kehribar/ice40helper/README.md

# ice40helper

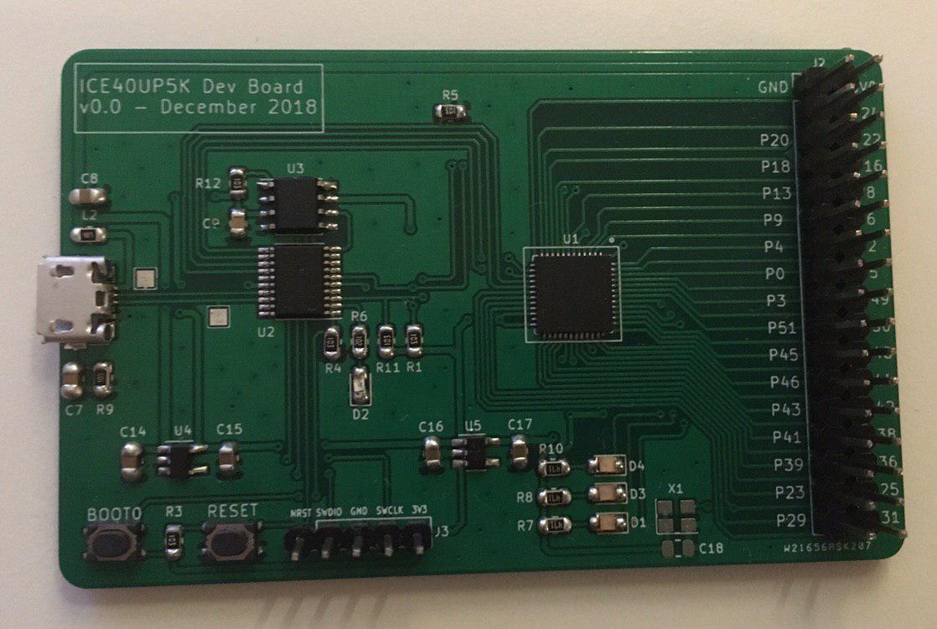
[picture p1: doc/proto_up5k.jpg]
