kehribar/ice40helper/hardware/up5k_v0/Readme.md

# UP5K Development Board

TODO: Add details ...
