kehribar/ice40helper/doc/proto_v0.jpg

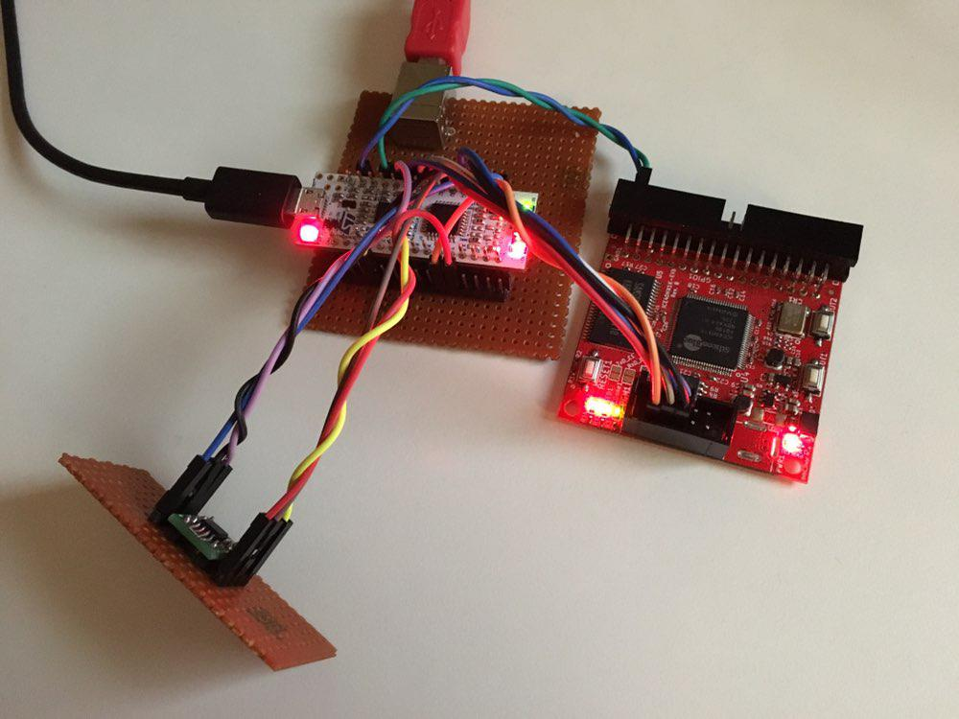
doc/proto_v0.jpg
