kehribar/ice40helper/hardware/up5k_v0/up5k_v0_brd.png

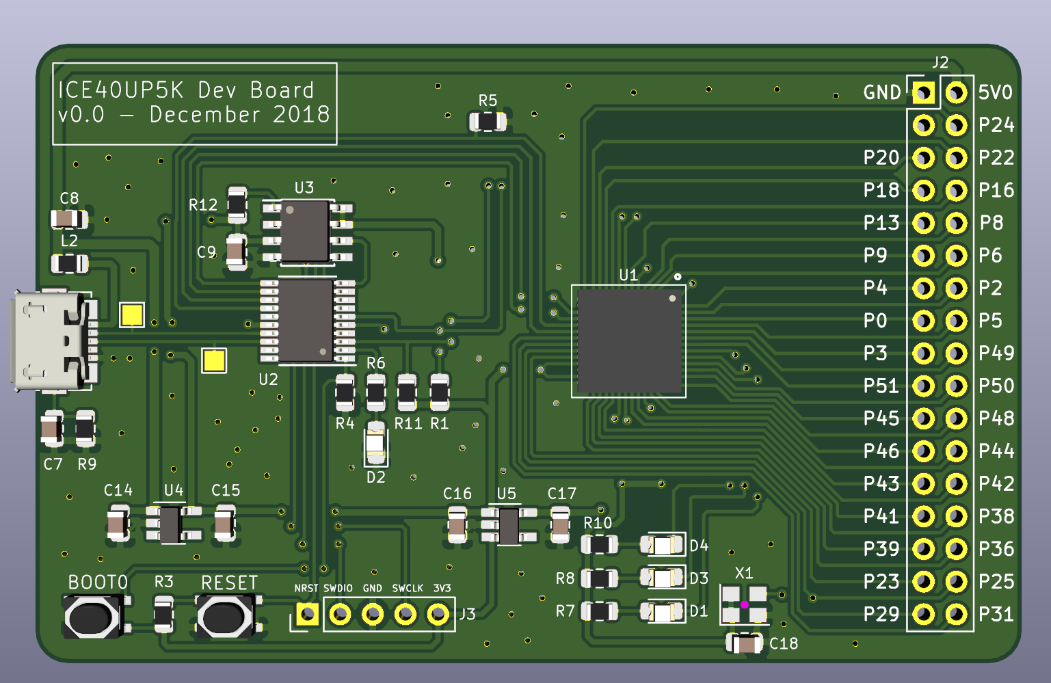
hardware/up5k_v0/up5k_v0_brd.png
