kehribar/ice40helper/hardware/up5k_v0/up5k_v0.pdf

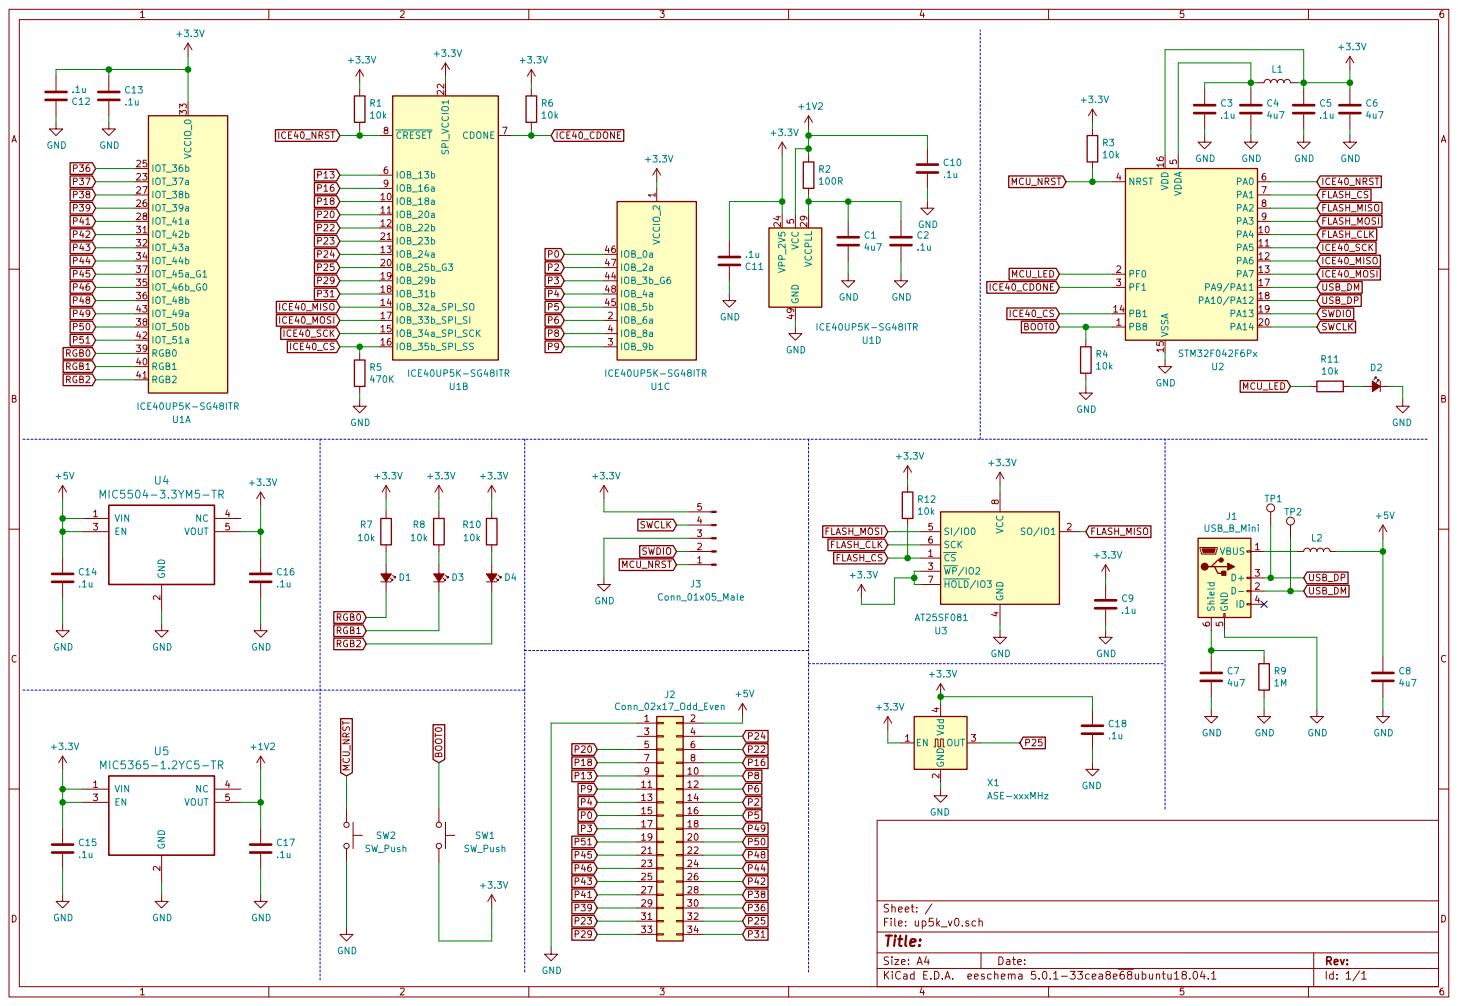
[picture p4: page 1]

2 VOUT 5 NC 4 VIN 1 EN 3 U4 MIC5504-3.3YM5-TR GND

4 SI/IO0 5 SCK 6 HOLD/IO3 7 VCC

2 VOUT 5 NC 4 VIN 1 EN 3 U5 MIC5365-1.2YC5-TR
