kehribar/ice40helper/hardware/up5k_v0/up5k_v0.kicad_pcb

## KiCad design hardware/up5k_v0/up5k_v0.kicad_pcb (2018-12-16)

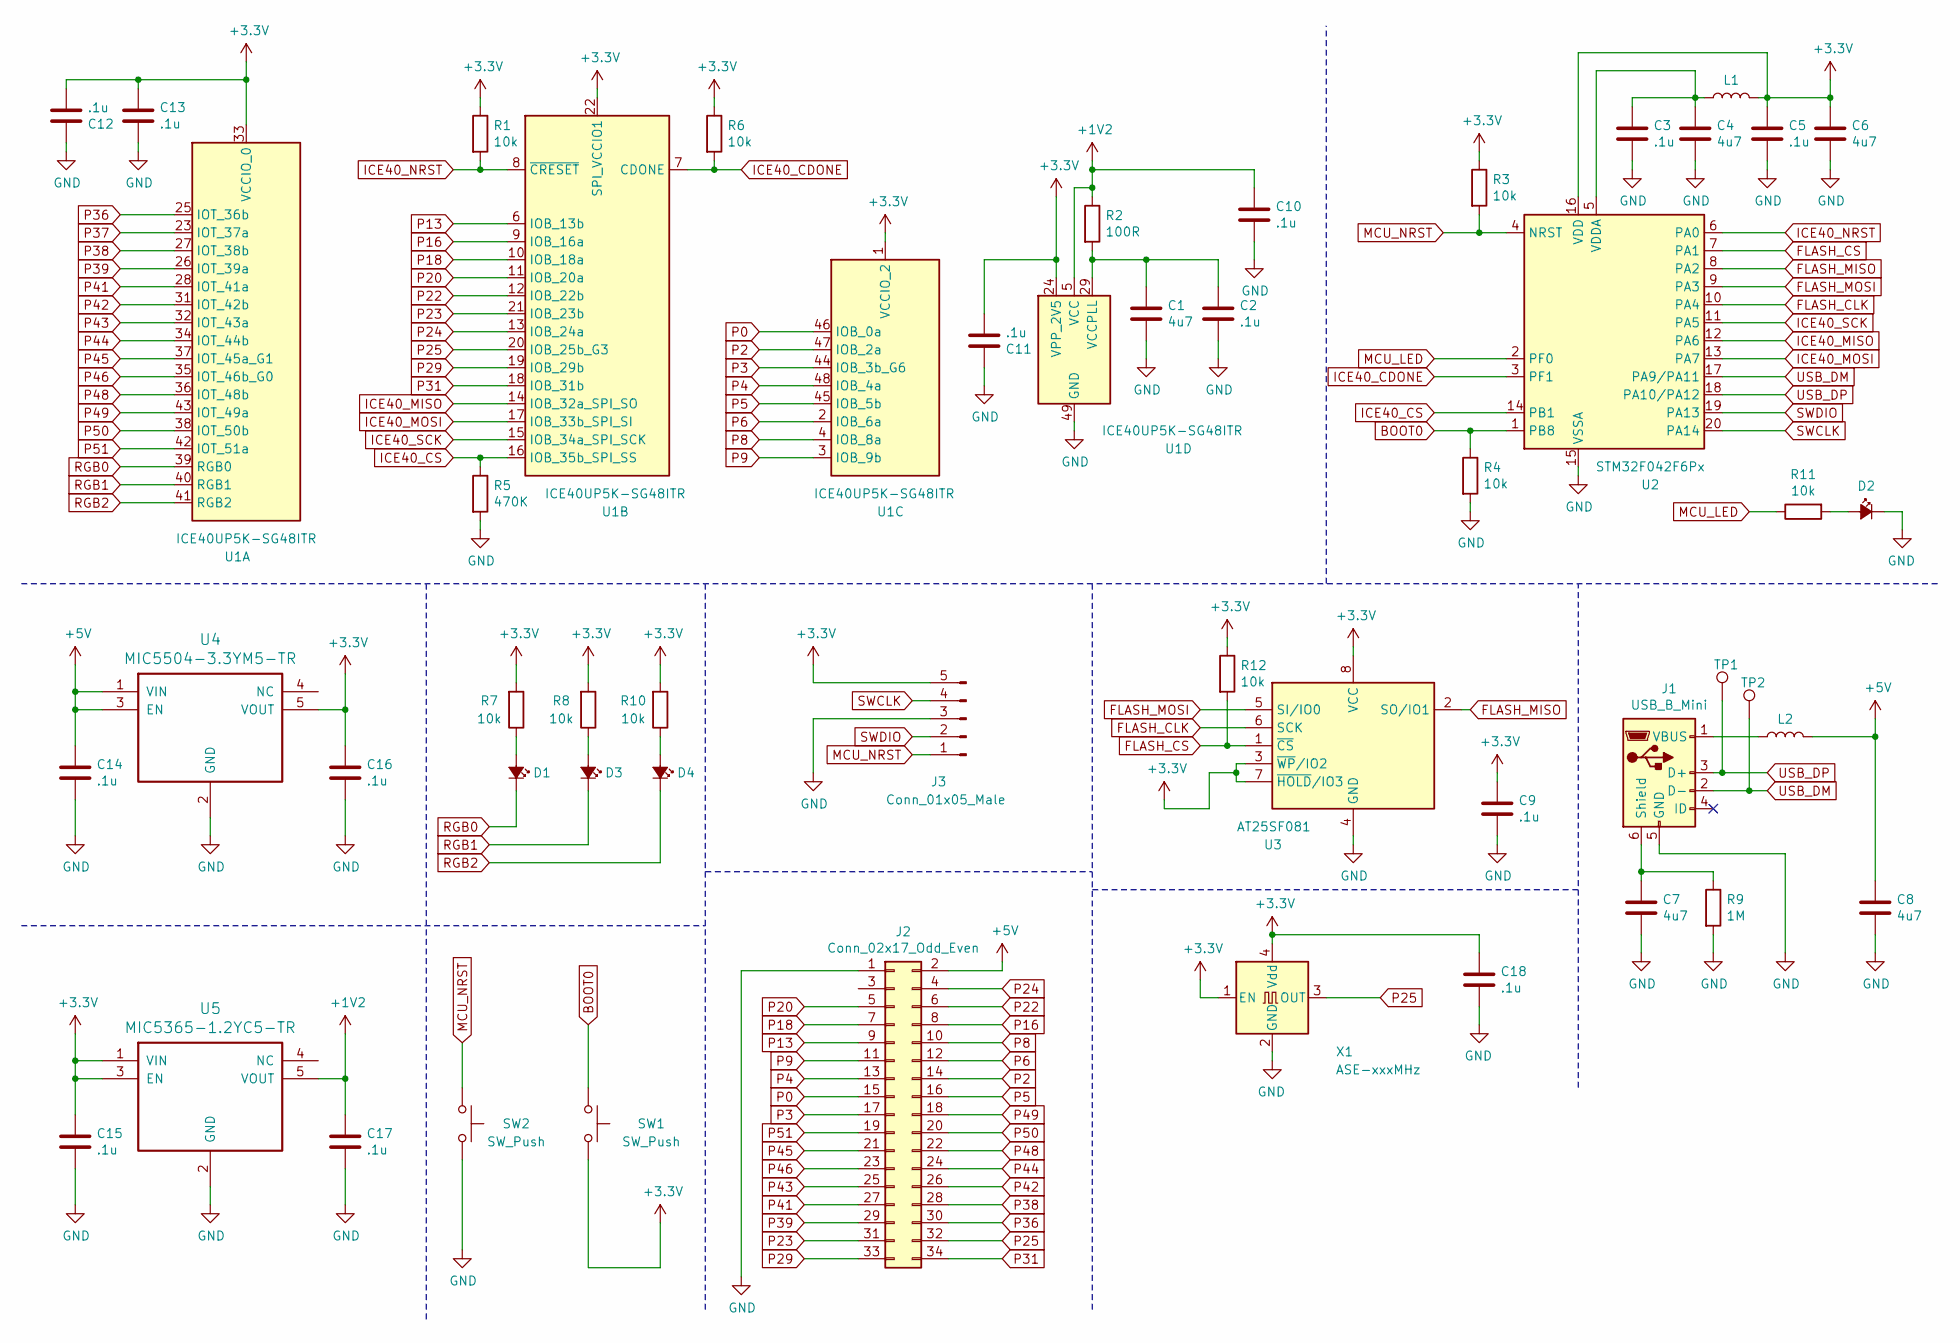
[picture p5: schematic up5k_v0.sch]

Parts:
C1, C4, C6, C7, C8: 4u7; C_0805_2012Metric
C2, C3, C5, C9, C10, C11, C12, C13, C14, C15, C16, C17, C18: .1u; C_0805_2012Metric
D1, D2, D3, D4: LED_Small_ALT; LED_0805_2012Metric_Castellated
J1: USB_B_Mini; USB_Micro-B_Molex_47346-0001
J2: Conn_02x17_Odd_Even; PinHeader_2x17_P2.54mm_Vertical
J3: Conn_01x05_Male; PinHeader_1x05_P2.54mm_Vertical
L1, L2: L; R_0805_2012Metric
R1, R3, R4, R6, R7, R8, R10, R11, R12: 10k; R_0805_2012Metric
R2: 100R; R_0805_2012Metric
R5: 470K; R_0805_2012Metric
R9: 1M; R_0805_2012Metric
SW1, SW2: SW_Push; PTS_810_SMT_Switch
TP1, TP2: TestPoint; TestPoint_Pad_1.5x1.5mm
U1: ICE40UP5K-SG48ITR; QFN-48-1EP_7x7mm_P0.5mm_EP5.6x5.6mm
U2: STM32F042F6Px; TSSOP-20_4.4x6.5mm_P0.65mm
U3: AT25SF081; SOIC-8_3.9x4.9mm_P1.27mm
U4: MIC5504-3.3YM5-TR; SOT-23-5_HandSoldering
U5: MIC5365-1.2YC5-TR; SOT-23-5_HandSoldering
X1: ASE-xxxMHz; Oscillator_SMD_Abracon_ASE-4Pin_3.2x2.5mm

Connections:
+1V2: C10.1, C17.1, R2.1, U1.5 (VCC), U1.30 (VCC), U5.5 (VOUT)
+3V3: C5.1, C6.1, C9.1, C11.2, C12.2, C13.1, C15.1, C16.1, C18.1, J3.5, L1.2, R1.1, R3.1, R6.1, R7.2, R8.2, R10.2, R12.1, SW1.2, U1.1 (VCCIO_2), U1.22 (SPI_VCCIO1), U1.24 (VPP_2V5), U1.33 (VCCIO_0), U2.16 (VDD), U3.3 (~WP~/IO2), U3.7 (~HOLD~/IO3), U3.8 (VCC), U4.5 (VOUT), U5.1 (VIN), U5.3 (EN), X1.1 (EN), X1.4 (Vdd)
+5V: C8.1, C14.1, J2.2, L2.2, U4.1 (VIN), U4.3 (EN)
BOOT0: R4.1, SW1.1, U2.1 (PB8)
FLASH_CLK: U2.10 (PA4), U3.6 (SCK)
FLASH_CS: R12.2, U2.7 (PA1), U3.1 (~CS)
FLASH_MISO: U2.8 (PA2), U3.2 (SO/IO1)
FLASH_MOSI: U2.9 (PA3), U3.5 (SI/IO0)
GND: C1.2, C2.2, C3.2, C4.2, C5.2, C6.2, C7.2, C8.2, C9.2, C10.2, C11.1, C12.1, C13.2, C14.2, C15.2, C16.2, C17.2, C18.2, D2.1 (K), J1.5 (GND), J2.1, J3.3, R4.2, R5.2, R9.2, SW2.2, U1.49 (GND), U2.15 (VSSA), U3.4 (GND), U4.2 (GND), U5.2 (GND), X1.2 (GND)
ICE40_CDONE: R6.2, U1.7 (CDONE), U2.3 (PF1)
ICE40_CS: R5.1, U1.16 (IOB_35b_SPI_SS), U2.14 (PB1)
ICE40_MISO: U1.14 (IOB_32a_SPI_SO), U2.12 (PA6)
ICE40_MOSI: U1.17 (IOB_33b_SPI_SI), U2.13 (PA7)
ICE40_NRST: R1.2, U1.8 (~CRESET), U2.6 (PA0)
ICE40_SCK: U1.15 (IOB_34a_SPI_SCK), U2.11 (PA5)
MCU_LED: R11.1, U2.2 (PF0)
MCU_NRST: J3.1, R3.2, SW2.1, U2.4 (NRST)
unnamed: C1.1, C2.1, R2.2, U1.29 (VCCPLL)
unnamed: C3.1, C4.1, L1.1, U2.5 (VDDA)
unnamed: C7.1, J1.6 (Shield), R9.1
unnamed: D1.2 (A), R7.1
unnamed: D2.2 (A), R11.2
unnamed: D3.2 (A), R8.1
unnamed: D4.2 (A), R10.1
unnamed: J1.1 (VBUS), L2.1
P0: J2.15, U1.46 (IOB_0a)
P2: J2.14, U1.47 (IOB_2a)
P3: J2.17, U1.44 (IOB_3b_G6)
P4: J2.13, U1.48 (IOB_4a)
P5: J2.16, U1.45 (IOB_5b)
P6: J2.12, U1.2 (IOB_6a)
P8: J2.10, U1.4 (IOB_8a)
P9: J2.11, U1.3 (IOB_9b)
P13: J2.9, U1.6 (IOB_13b)
P16: J2.8, U1.9 (IOB_16a)
P18: J2.7, U1.10 (IOB_18a)
P20: J2.5, U1.11 (IOB_20a)
P22: J2.6, U1.12 (IOB_22b)
P23: J2.31, U1.21 (IOB_23b)
P24: J2.4, U1.13 (IOB_24a)
P25: J2.32, U1.20 (IOB_25b_G3), X1.3 (OUT)
P29: J2.33, U1.19 (IOB_29b)
P31: J2.34, U1.18 (IOB_31b)
P36: J2.30, U1.25 (IOT_36b)
P37: U1.23 (IOT_37a)
P38: J2.28, U1.27 (IOT_38b)
P39: J2.29, U1.26 (IOT_39a)
P41: J2.27, U1.28 (IOT_41a)
P42: J2.26, U1.31 (IOT_42b)
P43: J2.25, U1.32 (IOT_43a)
P44: J2.24, U1.34 (IOT_44b)
P45: J2.21, U1.37 (IOT_45a_G1)
P46: J2.23, U1.35 (IOT_46b_G0)
P48: J2.22, U1.36 (IOT_48b)
P49: J2.18, U1.43 (IOT_49a)
P50: J2.20, U1.38 (IOT_50b)
P51: J2.19, U1.42 (IOT_51a)
RGB0: D1.1 (K), U1.39 (RGB0)
RGB1: D3.1 (K), U1.40 (RGB1)
RGB2: D4.1 (K), U1.41 (RGB2)
SWCLK: J3.4, U2.20 (PA14)
SWDIO: J3.2, U2.19 (PA13)
USB_DM: J1.2 (D-), TP2.1, U2.17 (PA9/PA11)
USB_DP: J1.3 (D+), TP1.1, U2.18 (PA10/PA12)

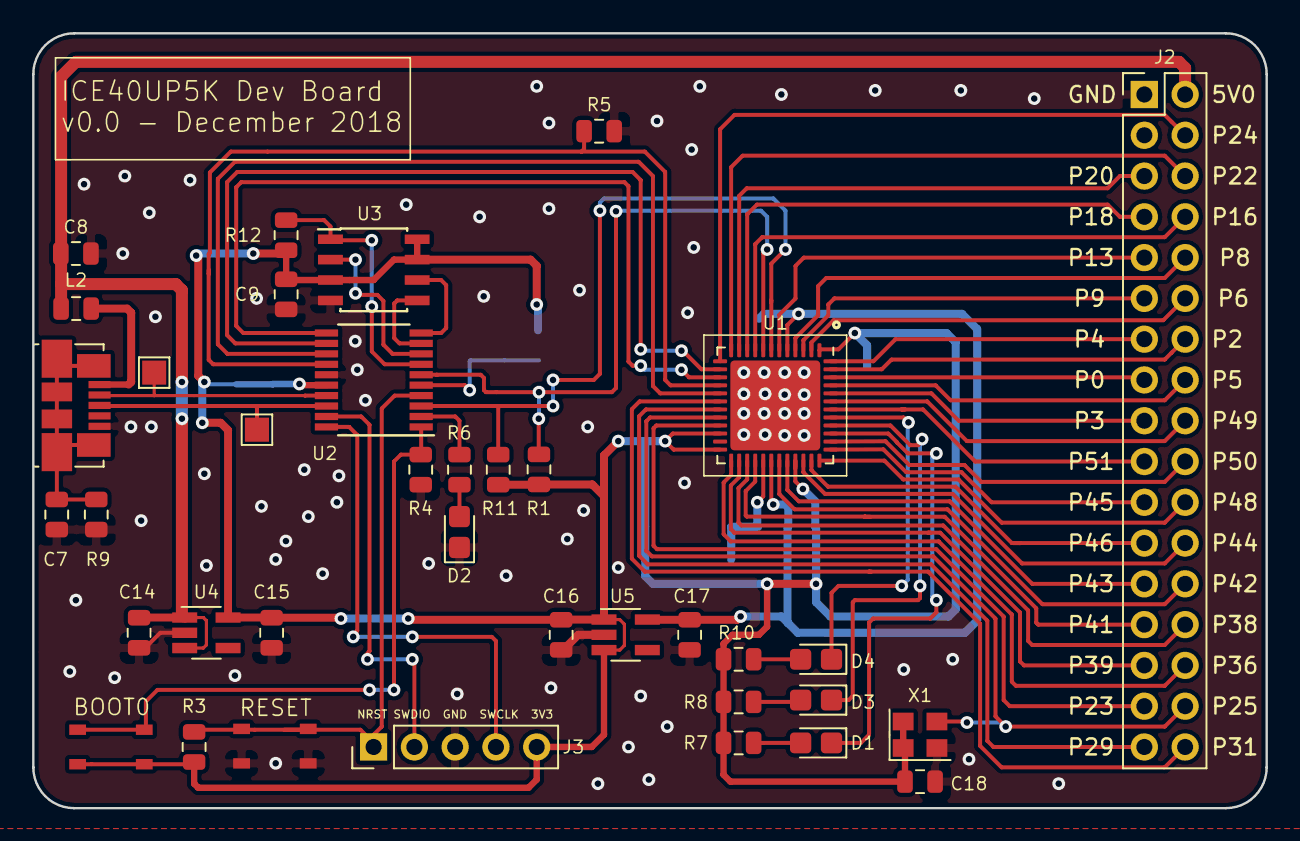
[picture p6: board up5k_v0.kicad_pcb from above]

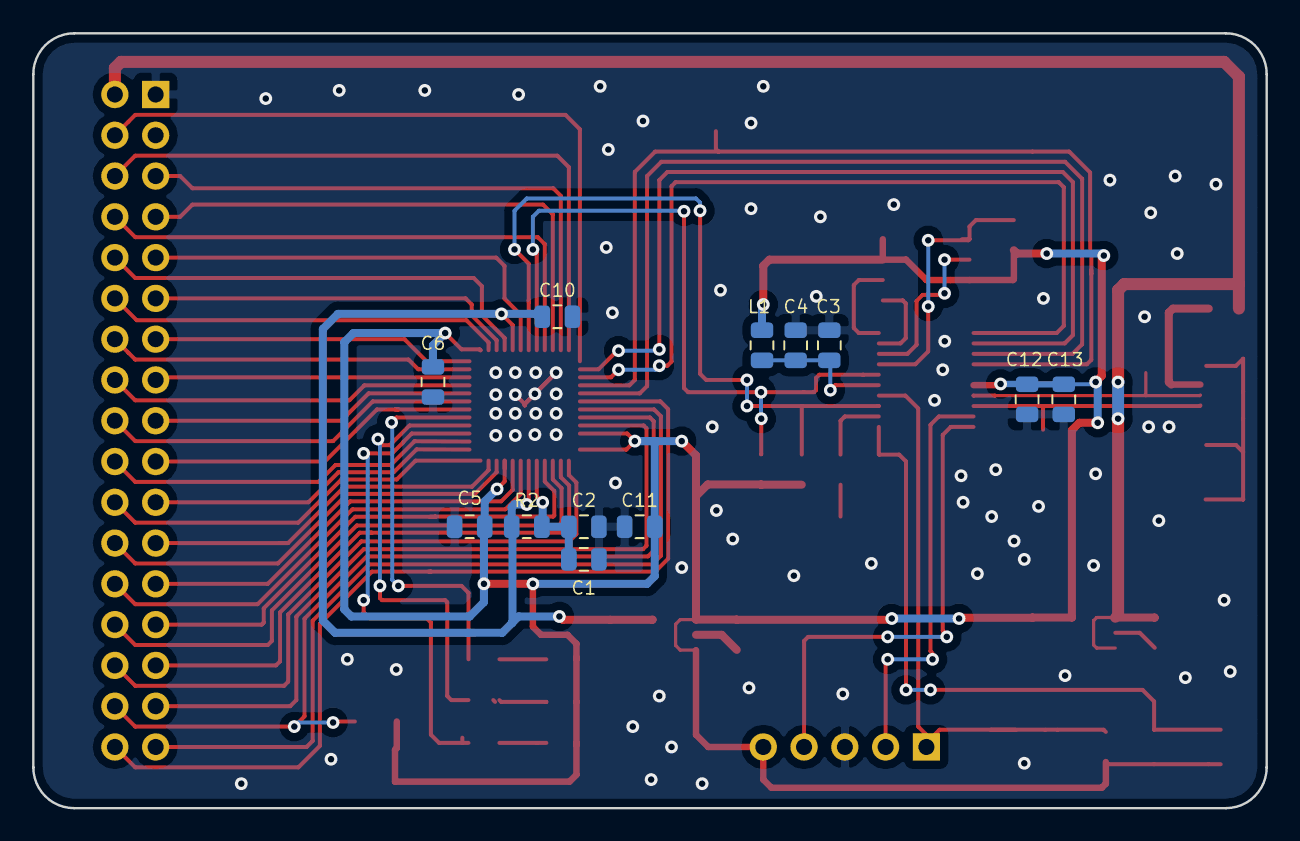
[picture p7: board up5k_v0.kicad_pcb from below]

Board: 2 copper layers, 76.8 x 48.3 mm, 49 parts (12 on the bottom side), 63 nets.
