kehribar/ice40helper/firmware/bytesutil.h

// ----------------------------------------------------------------------------
// 
// 
// ----------------------------------------------------------------------------
#ifndef BYTESUTIL_H
#define BYTESUTIL_H

// ----------------------------------------------------------------------------
#include <stdint.h>

// ----------------------------------------------------------------------------
uint32_t make32b(uint8_t* buff, uint32_t base);

// ----------------------------------------------------------------------------
void put32b(uint8_t* buff, uint32_t base, uint32_t data);

// ----------------------------------------------------------------------------
#endif
