kehribar/ice40helper/firmware/ice40data.h

// ----------------------------------------------------------------------------
// 
// 
// ----------------------------------------------------------------------------
#include <stdint.h>

// ----------------------------------------------------------------------------
uint32_t ice40data_readRegister32b(uint8_t address);

// ----------------------------------------------------------------------------
void ice40data_writeRegister32b(uint8_t address, uint32_t data);
