kehribar/ice40helper/firmware/ice40prog.h

// ----------------------------------------------------------------------------
// 
// 
// ----------------------------------------------------------------------------
#include <stdint.h>

// ----------------------------------------------------------------------------
void ice40prog_init();

// ----------------------------------------------------------------------------
void ice40prog_start();

// ----------------------------------------------------------------------------
void ice40prog_finish();

// ----------------------------------------------------------------------------
void ice40prog_txData(uint8_t* buf, int32_t buflen);

// ----------------------------------------------------------------------------
void ice40prog_loadFromSpiFlash(uint32_t baseAddress);
