kehribar/ice40helper/firmware/spiFlash.h

// ----------------------------------------------------------------------------
//
//
// ----------------------------------------------------------------------------
#ifndef SPIFLASH
#define SPIFLASH

// ----------------------------------------------------------------------------
#include <stdint.h>

// ----------------------------------------------------------------------------
void spiFlash_init();

// ----------------------------------------------------------------------------
uint8_t spiFlash_check_ID();

// ----------------------------------------------------------------------------
void spiFlash_read_data(uint32_t address, uint32_t length, uint8_t* data);

// ----------------------------------------------------------------------------
void spiFlash_write_enable();

// ----------------------------------------------------------------------------
void spiFlash_write_disable();

// ----------------------------------------------------------------------------
void spiFlash_write_data(uint32_t address, uint32_t length, uint8_t* data);

// ----------------------------------------------------------------------------
void spiFlash_sectorErase(uint32_t address);

// ----------------------------------------------------------------------------
uint8_t spiFlash_readStatus();

// ----------------------------------------------------------------------------
uint8_t spiFlash_isBusy();

// ----------------------------------------------------------------------------
void spiFlash_write_initalise(uint32_t address);

// ----------------------------------------------------------------------------
void spiFlash_write_push(uint8_t* data, uint32_t length);

// ----------------------------------------------------------------------------
void spiFlash_write_finalise();

// ----------------------------------------------------------------------------
#endif
