kehribar/ice40helper/firmware/systick_delay.h

// ----------------------------------------------------------------------------
// 
// 
// ----------------------------------------------------------------------------
#include <stdint.h>

// ----------------------------------------------------------------------------
void systick_delay_init();

// ----------------------------------------------------------------------------
uint32_t systick_getCounter1ms();

// ----------------------------------------------------------------------------
void _delay_ms(uint32_t arg);
