kehribar/ice40helper/firmware/usb.h

// ----------------------------------------------------------------------------
// 
// 
// ----------------------------------------------------------------------------
#include <stdint.h>

// ----------------------------------------------------------------------------
void usb_init();

// ----------------------------------------------------------------------------
void usb_poll();

// ----------------------------------------------------------------------------
uint8_t usb_isConnected();

// ----------------------------------------------------------------------------
int32_t usb_rxDataAmount();

// ----------------------------------------------------------------------------
void usb_rxData(uint8_t* buf, int32_t buflen);

// ----------------------------------------------------------------------------
void usb_txData(uint8_t* buf, int32_t buflen);

// ----------------------------------------------------------------------------
void usb_txData_direct(uint8_t* buf, int32_t buflen);

// ----------------------------------------------------------------------------
// Don't use this method unless you want to have a very bad data transfer
// performance! Mainly this will be used for output function for xprintf
// library where raw data transfer speed is _not_ the first priority.
// ----------------------------------------------------------------------------
void usb_sendChar(uint8_t ch);

void clear_buffer();
