kehribar/ice40helper/(commit log)

2018-11-23 Make SPI transfer generic.
2018-12-05 Non-volatile configuration support with SPI flash connected to STM32
2018-12-16 UP5K board initial commit.
    [up5k_v0-B.Cu.gbl, up5k_v0-B.Mask.gbs, up5k_v0-B.Paste.gbp, up5k_v0-B.SilkS.gbo, up5k_v0-Edge.Cuts.gm1, up5k_v0-F.Cu.gtl, up5k_v0-F.Mask.gts, up5k_v0-F.Paste.gtp]
2018-12-26 SPI flash interface changed from bitbang to hardware
2018-12-26 TSSOP20 package specific pin remapping
2018-12-26 Hardware modifications for up5k board
2018-12-26 Set LED high while executing a commmand
2019-01-01 Addded SPI read/write interface. Improved usb layer.
2019-01-01 SPI read/write example
2019-01-08 Update readme with prototype image.
2020-06-20 SPI core bugfix. Faster implementation (fMax = ~52 MHz)
    [cmdspi.v, cmdspi_tb.v]
